sandhraj/sheetmetal-tool-desk-stand/dxf/LOWER_PLATE.dxf

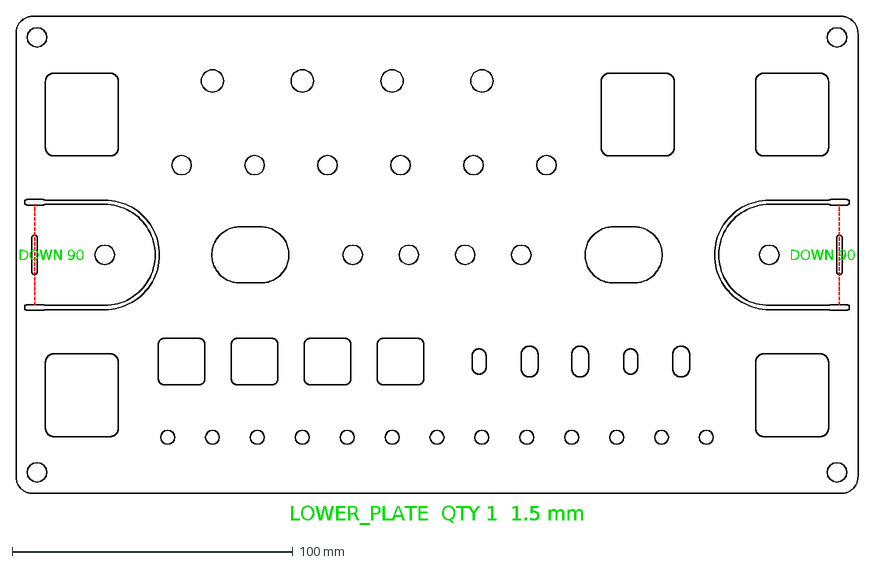
[picture p7: CAD file, 2026-10-25]
dxf/LOWER_PLATE.dxf
DOWN 90
LOWER_PLATE QTY 1 1.5 mm
