sandhraj/sheetmetal-tool-desk-stand/dxf/TOOL_STAND_NESTED_ALL_PARTS.dxf

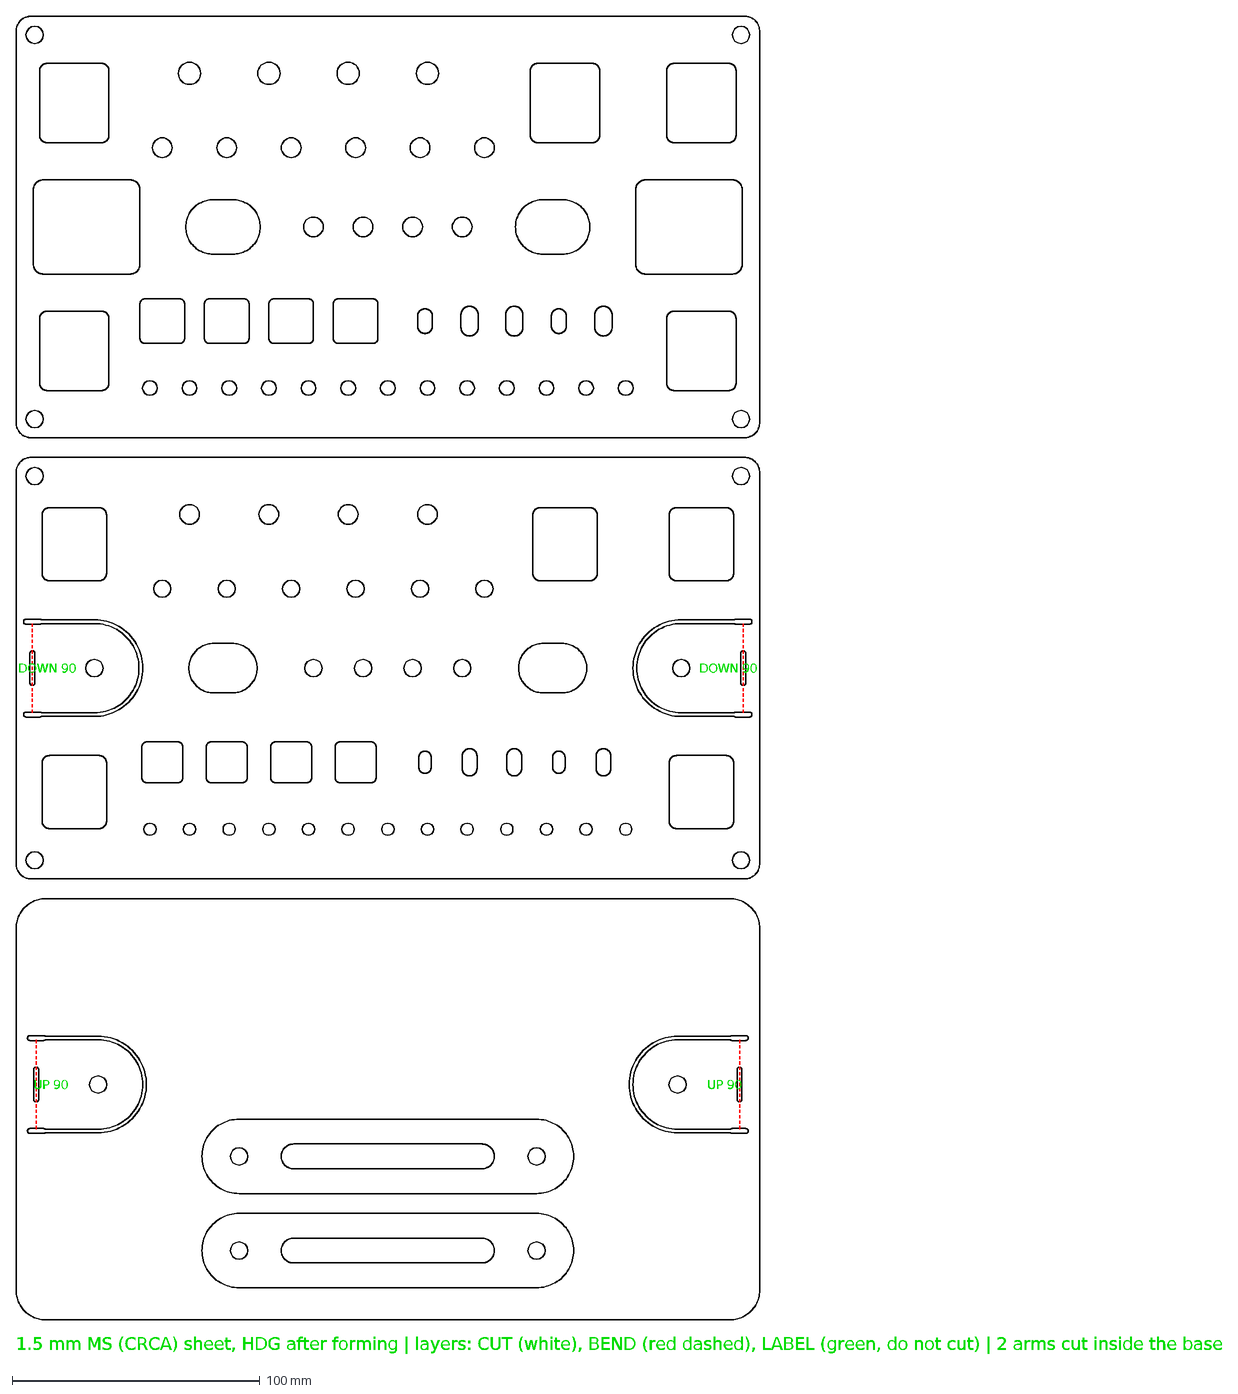
[picture p8: CAD file, 2026-10-25]
dxf/TOOL_STAND_NESTED_ALL_PARTS.dxf
UP 90
DOWN 90
1.5 mm MS (CRCA) sheet, HDG after forming | layers: CUT (white), BEND (red dashed), LABEL (green, do not cut) | 2 arms cut inside the base
