sandhraj/sheetmetal-tool-desk-stand/dxf/BASE.dxf

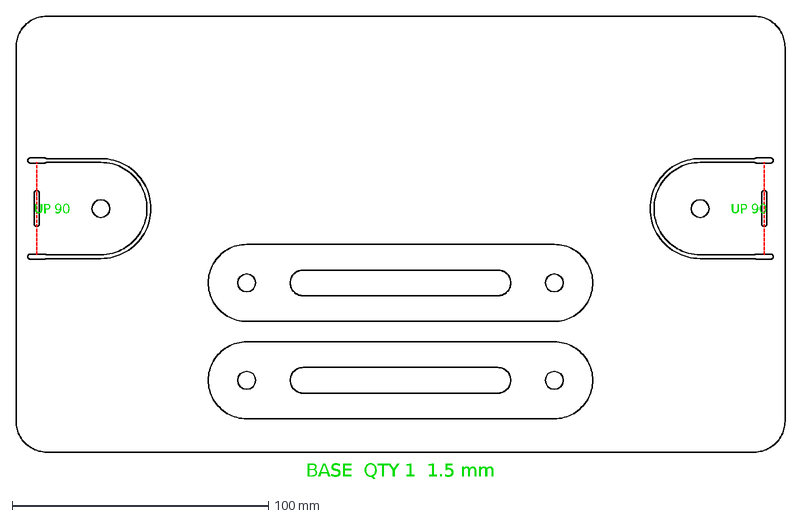
[picture p9: CAD file, 2026-10-25]
dxf/BASE.dxf
UP 90
BASE QTY 1 1.5 mm
