sandhraj/sheetmetal-tool-desk-stand/dxf/ARM.dxf

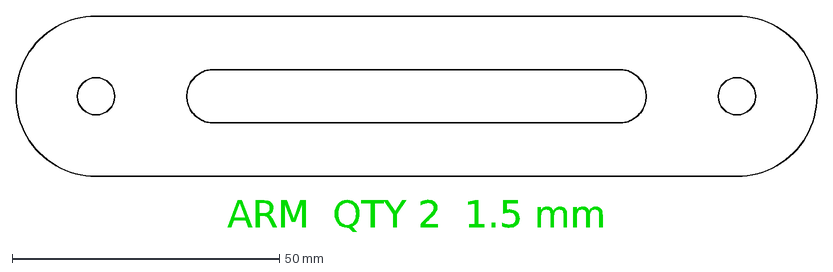
[picture p10: CAD file, 2026-10-25]
dxf/ARM.dxf
ARM QTY 2 1.5 mm
