sandhraj/sheetmetal-tool-desk-stand/dxf/TOP_PLATE.dxf

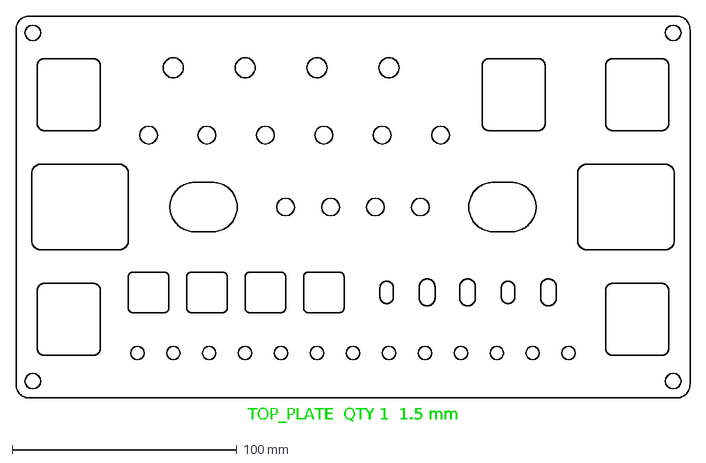
[picture p11: CAD file, 2026-10-25]
dxf/TOP_PLATE.dxf
TOP_PLATE QTY 1 1.5 mm
